RobK-0/PacificSound_SplitKeyboard/KiCad/PacificSound.sch

## KiCad design KiCad/PacificSound.sch (2022-01-25)

Schematic: PacificSound.sch

Parts:
D1, D2, D3, D4, D5, D6, D7, D8, D9, D10, D11, D12, D13, D14, D15, D16, D17, D18, D19, D20, D21, D22: D; D_TH_SMD
H1, H2, H3, H4, H5, H6, H7, H8: M2; MountingHole_2.2mm_M2_Pad
H9: M2; RightSideArt
H10: M2; LeftSideArt
J1: 8P8C; GMX-SMT2-S-88
SW1, SW2, SW3, SW4, SW5, SW6, SW7, SW8, SW9, SW10, SW11, SW12, SW13, SW14, SW15, SW16, SW17, SW20, SW21: SW_Push; MX_ALPS_PG1350_noLed
SW18, SW19, SW22: Rotary_Encoder_Switch; MX_ALPS_PG1350_Rotary
U1: Conn_02x20_Counter_Clockwise; BlackPill
