RobK-0/PacificSound_SplitKeyboard/Firmware/Example-C-code/STMF401_LeftHalf/Pacific_Sound_STM32F401_Left_V1.ioc

Mcu.UserName=STM32F401CCUx
PA10.Signal=GPIO_Output
PA11.Signal=USB_OTG_FS_DM
PA12.Signal=USB_OTG_FS_DP
PA4.Signal=SPI1_NSS
PA5.Signal=SPI1_SCK
PA6.Signal=SPI1_MISO
PA7.Signal=SPI1_MOSI
PA8.Signal=GPIO_Input
PA9.Signal=GPIO_Output
PB1.Signal=GPIO_Output
PB10.Signal=GPIO_Input
PB12.Signal=GPIO_Input
PB13.Signal=GPIO_Input
PB14.Signal=GPIO_Input
PB15.Signal=GPIO_Input
PB2.Signal=GPIO_Output
PB4.Signal=S_TIM3_CH1
PB5.Signal=S_TIM3_CH2
PC13-ANTI_TAMP.Signal=GPIO_Output
PC14-OSC32_IN.Signal=RCC_OSC32_IN
PC15-OSC32_OUT.Signal=RCC_OSC32_OUT
