RobK-0/PacificSound_SplitKeyboard/(commit log)

2022-01-25 Addition of KiCad PCB files
    [PacificSound.sch]
2022-02-08 Updated sample firmware to the STM32F401 setup with encoders. Included source files generated by the STM32CubeIDE software.
2022-02-13 Connected two switch pads that should have been connected.
